LukasOtis/MineralEpoxyCNC/README.md

# MineralEpoxyCNC
Information and files for my mineral epoxy CNC build
