LukasOtis/MineralEpoxyCNC/partslist.xlsx

CNC-Parts
number |  | name | Subassembly | crit. Dimensions | order date | inventory | used | pos | cost | tot. Cost | 3D-Modell | processed | tested
Strucktual 01
001 | 01 | Railsupportplate Y | HGH20_Rail | 50x10x500 12€/m | 2021-02-03 | 2 | 2 | 0 | 6.13 € | 12.27 € | +
002 | 01 | Railsupportplate X | HGH20_Rail_600 | 50x10x600 | 2021-05-02 | 2 | 2 | 0 | 10.24 € | 20.48 € | -
003 | 01 | Railsupportplate Z | HGH20_Rail_400 | 50x10x400 | 2021-02-03 | 2 | 2 | 0 | 4.80 € | 9.60 € | +
004 | 01 | Ballscrewsupportplate | SFU1650_Y_2 | 80x5x360 10€/m | 2021-02-03 | 3 | 3 | 0 | 3.80 € | 11.40 € | +
005 | 01 | Stepper-Holder Y |  | 80x80x5 | 2021-02-03 | 1 | 1 | 0 | 0.50 € | 0.50 € | +
006 | 01 | Stepper-Holder X |  | 80x50x5 | 2021-02-03 | 1 | 1 | 0 | 0.90 € | 0.90 € | +
007 | 01 | Stepper-Holder Z |  | 120x80x5 | 2021-02-03 | 1 | 1 | 0 | 1.20 € | 1.20 € | +
008 | 01 | Y-Axis-top |  | 300x200x10 | 2021-04-05 | 1 | 1 | 0 | 22.80 € | 22.80 € | +
009 | 01 | Y-X-Connetor |  | 100x200x10 | 2021-04-05 | 2 | 2 | 0 | 10.46 € | 20.92 € | +
010 | 01 | Y-Standoff |  | 100x40x15 | 2021-04-11 | 2 | 2 | 0 | 5.00 € | 10.00 € | +
011 | 01 | X-Top-Plate |  | 240x210x10 | 2020-04-19 | 1 | 1 | 0 | 7.50 € | 7.50 € | +
012 | 01 | Z-Connector |  | 300x150x10 | 2021-04-05 | 2 | 2 | 0 | 18.14 € | 36.28 € | +
013 | 01 | Z-Top-Plate |  | 240x210x10 | 2020-04-19 | 1 | 1 | 0 | 7.50 € | 7.50 € | +
014 | 01 | Z-UpperConnector |  | 150x40x15 | 2021-04-11 | 2 | 2 | 0 | 5.00 € | 10.00 € | -
015 | 01 | Spindel-Sides | Spindel | 150x100x20 |  |  |  |  |  |  | +
016 | 01 | Spindel-front | Spindel | 150x100x10 |  |  |  |  |  |  | +
017 | 01 | T-Slot-Plate |  | 400x300x25 |  |  | 1 | 0 | 90.00 € | 90.00 € | +
018 | 01 | Granit split 8-12mm |  | 8-12mm 25kg | 2021-02-28 | 1 | 1 | 0 | 7.99 € | 7.99 €
019 | 01 | Basaltsplitt 2-5mm |  | 2-5mm 25kg | 2021-02-28 | 1 | 1 | 0 | 5.35 € | 5.35 €
020 | 01 | Brechsand 0-2mm |  | 0-2 mm 25 kg | 2021-02-28 | 1 | 1 | 0 | 4.95 € | 4.95 €
021 | 01 | Casting zubehöhr (Eimer/behälter/Schalung |  |  | 2021-02-28 |  |  |  |  | 77.67 €
021 | 01 | Epoxidhartz 1kg |  | 1kg | 2021-02-28 | 1 | 1 | 0 | 19.99 € | 19.99 €
022 | 01 | Epoxidhartz 10kg |  | 10kg | 2021-05-09 | 1 | 1 | 0 | 92.99 € | 92.99 €
023 | 01 | Füße |  | M8x50 | 2021-04-22 | 8 | 6 | 2 |  | 17.00 €
024 | 01 | Holzgehäuse |  |  | 2021-11-15 | 1 | 1 | 0 | 100.50 € | 100.50 €
025 | 01 | Aluminum Extrusion |  |  | 2023-02-06 | 1 | 1 | 0 | 205.85 € | 205.85 €
 |  |  |  |  |  |  |  |  | total | 793.64 €
Movement 02
001 | 02 | SFU1605 350mm & BK BF12 Festlager |  | 1605x350 5mm Pitch | 2019-11-17 | 2 | 2 | 0 | 36.75 € | 73.50 € | +
002 | 02 | SFU1605 500mm & BK BF12 Festlager |  | 1605x500 5mm Pitch | 2021-03-26 | 1 | 1 | 0 | 32.00 € | 32.00 € | +
003 | 02 | 1x HGR20 500mm + 4x HGC20 Wagen |  | HGR20 500mm | 2021-03-26 | 1 | 1 | 0 | 50.00 € | 50.00 € | +
004 | 02 | 1x HGR20 400mm + 4x HGC20 Wagen |  | HGR20 400mm | 2021-03-01 | 1 | 1 | 0 | 39.99 € | 39.99 € | +
005 | 02 | 1x HGR20 600mm + 4x HGC20 Wagen |  | HGR20 600mm |  |  | 1 | -1 |  |  | -
006 | 02 | Wellenkupplung 10mm/8mm |  | 10mm/8mm | 2019-11-18 | 3 | 0 | 3 | 4.90 € | 14.70 € | +
007 | 02 | GT2 60 Zahn/10mm Pulley |  | 60Zahn/10mm | 2021-01-31 | 3 | 3 | 0 | 7.56 € | 22.68 € | +
008 | 02 | GT2 40 Zahn/10mm Pulley |  | 40Zahn/10mm | 2021-04-04 | 1 | 2 | -1 | 4.89 € | 4.89 € | -
009 | 02 | GT2 20 Zahn/8mm Pulley |  | 20Zahn/8mm | 2021-01-31 | 3 | 3 | 0 | 1.81 € | 5.43 € | +
010 | 02 | GT2 10mm Riehmen 200mm |  | 10mm/200mm | 2021-01-31 | 5 | 3 | 2 | 3.50 € | 17.50 € | +
 |  |  |  |  |  |  |  |  | total | 260.69 €
Electronics and controll 03
001 | 03 | Mach 3 Breakout Board |  |  | 2018 | 1 | 1 | 0 | 5.53 € | 5.53 € | o
002 | 03 | Stepper Driver DM556 |  | 20-50V 4.2A | 2021-03-26 | 3 | 3 | 0 | 16.71 € | 50.13 €
003 | 03 | Stepper Motor Driver TB6600 |  | 5-40V 4.2A | 2018 | 4 | 4 | 0 | 8.50 € | 34.00 € | o
004 | 03 | 36V Power Supply 5A |  | 36V 5A | 2018 | 1 | 1 | 0 | 24.00 € | 24.00 € | o
005 | 03 | Intel Atom PC |  |  | 2018 | 1 | 1 | 0 | 40.00 € | 40.00 € | o
006 | 03 | Nema 23 Stepper Motor 270 oz-in 3A |  | 3A, 1.9Nm | 2019-11-18 | 3 | 3 | 0 | 20.40 € | 61.20 € | +
007 | 03 | Inductive end stops |  |  |  |  | 6 | -6
008 | 03 | Tool-probe |  |  |  |  | 1 | -1
009 | 03 | Toshiba Frequenzumrichter VSF9S-2015PL-WP |  |  |  | 1 | 1 | 0 | 73.00 € | 73.00 €
023 | 01 | Spindel 80mm, 1.5kW |  | 80x188 | 2021-07-19 | 1 | 1 | 0 | 176.12 € | 176.12 €
010 | 03 | Hechsen Contactor |  |  | 2021-04-10 | 1 | 1 | 0 | 9.99 € | 9.99 €
011 | 03 | Sicherung |  |  | 2021-07-23 | 1 | 1 | 0 | 4.00 € | 4.00 €
012 | 03 | Stromstoßschalter |  |  | 1900-01-14 | 1 | 1 | 0 | 10.90 € | 10.90 €
013 | 03 | FI Typ B für FI |  |  | 2021-05-07 | 1 | 1 | 0 | 66.90 € | 66.90 €
014 | 03 | Schaltschrank |  |  | 2021-10-27 | 1 | 1 | 0 | 35.19 € | 35.19 €
 |  |  |  |  |  |  |  |  | total | 590.96 €
Cable, Connections and Cablemanagement 04
001 | 04 | GX12 2 pin |  |  | 2021-03-10 | 10 | 6 | 4 | 1.10 € | 10.99 €
002 | 04 | GX12 4 pin |  |  | 2021-03-10 | 10 | 6 | 4 | 1.30 € | 12.99 €
 |  | 2x0.14mm2 LiYY Kabel 25m |  | 2x0.14mm2 25m | 2021-03-07 | 1 | 1 | 0 | 7.50 € | 7.50 €
 |  | 4x0.34mm2 LiYY Kabel 25m |  | 4x0.34mm2 25m | 2021-03-07 | 1 | 1 | 0 | 11.00 € | 11.00 €
 |  | 0.25mm2 Lize 10m colors |  | 0.25mm2 10m | 2021-03-07 | 8 | 8 | 0 | 2.60 € | 20.80 €
003 | 04 | Kippschalter 5x |  |  | 2021-03-10 | 5 | 2 | 3 | 1.20 € | 5.99 €
004 | 04 | Druckschalter 10x |  |  | 2021-03-10 | 10 | 2 | 8 | 0.90 € | 8.99 €
005 | 04 | Not-Aus |  |  | 2021-03-10 | 1 | 1 | 0 | 3.40 € | 3.40 €
006 | 04 | Maschinenschalter |  |  | 2021-03-10 | 1 | 1 | 0 | 2.38 € | 2.38 €
007 | 04 | DIN Rail Enden |  |  | 1900-01-22 | 1 | 1 | 0 | 4.00 € | 4.00 €
008 | 04 | Plugable Terminal |  |  | 2021-07-20 | 3 | 3 | 0 | 6.08 € | 18.24 €
009 | 04 | Power destibution board |  |  | 2021-07-20 | 2 | 2 | 0 | 3.30 € | 6.60 €
010 | 04
011 | 04 | Kaltgeräte Terminal |  |  | 2021-07-20 | 1 | 1 | 0 | 4.00 € | 4.00 €
 |  |  |  |  |  |  |  |  | total | 116.88 €
Screws and holddowns 05
 |  | HammerNut8 M6 |  | Nut8 M6 | 2021-02-24 | 50 | 50 | 0 |  | 11.99 €
 |  | Zylinderschraube M5x12 |  | M5x12 | 2021-02-24 | 100 | 100 | 0 |  | 6.08 €
 |  | Zylinderschraube M5x16 |  | M5x16 | 2021-02-24 | 50 | 50 | 0 |  | 3.84 €
 |  | Zylinderschraube M6x12 |  | M6x12 | 2021-02-24 | 100 | 100 | 0 |  | 7.49 €
 |  | Zylinderschraube M6x35 |  | M6x35 | 2021-02-24 | 20 | 20 | 0 |  | 4.90 €
 |  |  |  |  |  |  |  |  | total | 34.30 €
 |  |  |  |  | nbr. Of parts | 78 |  |  | price | 1796.47 €
