LukasOtis/MineralEpoxyCNC/CNC_master v4.2 v40.3mf

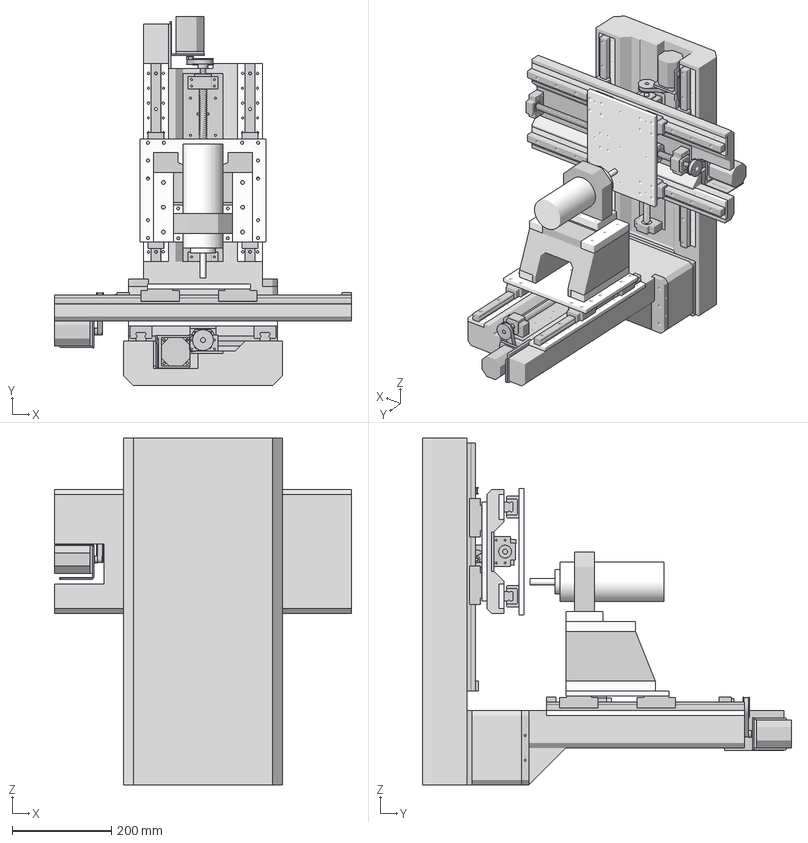
[picture p1: CAD file, 2024-09-27]
CNC_master v4.2 v40.3mf
600.0 x 745.1 x 700.0 mm
Körper1 x 71
Körper10
Körper2 x 24
Körper3 x 3
