LukasOtis/MineralEpoxyCNC/(commit log)

2024-09-27 added project files
    [CNC_master v4.2 v40.3mf, Mineralguss.xlsx, partslist.xlsx]
2024-10-13 added linux CNC config files
    [custom_postgui.hal, postgui_call_list.hal, remora-flexi.hal, remora-flexi.ini, time.hal]
